volzotan/MirrorForge/simulation/data/mirror.stl

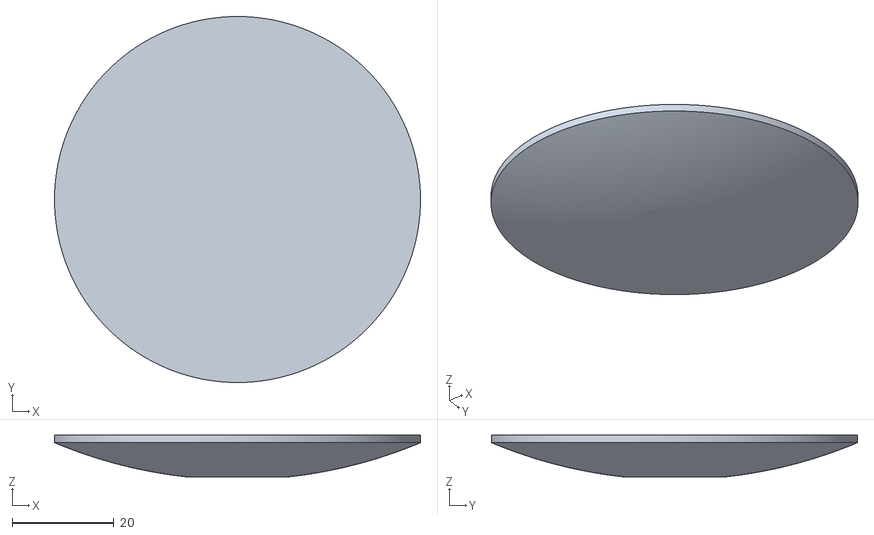
[picture p4: CAD file, 2021-10-08]
simulation/data/mirror.stl
72.0 x 72.0 x 8.23
