volzotan/MirrorForge/simulation/data/CameraWedgeTangible_Head.stl

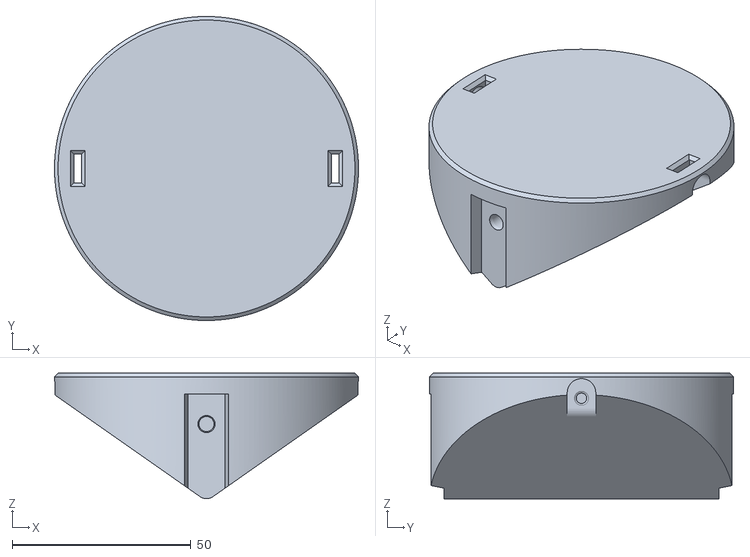
[picture p6: CAD file, 2021-10-08]
simulation/data/CameraWedgeTangible_Head.stl
85.0 x 85.0 x 35.1
