volzotan/MirrorForge/simulation/data/Halopro_base1.stl

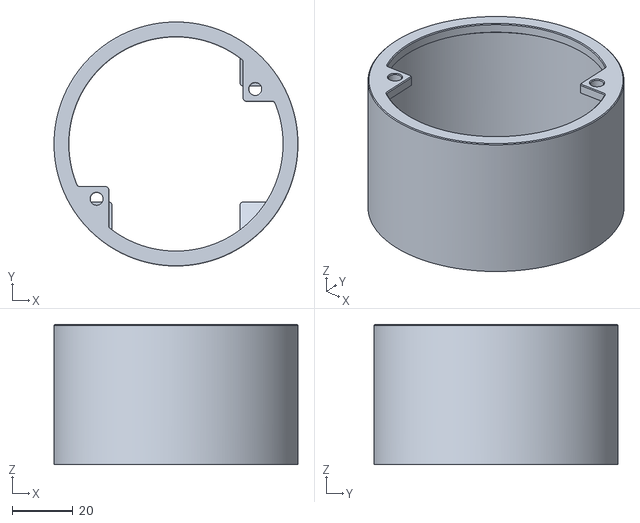
[picture p7: CAD file, 2021-10-08]
simulation/data/Halopro_base1.stl
80.0 x 80.0 x 46.0
