volzotan/MirrorForge/simulation/data/CameraWedgeTangible_Base.stl

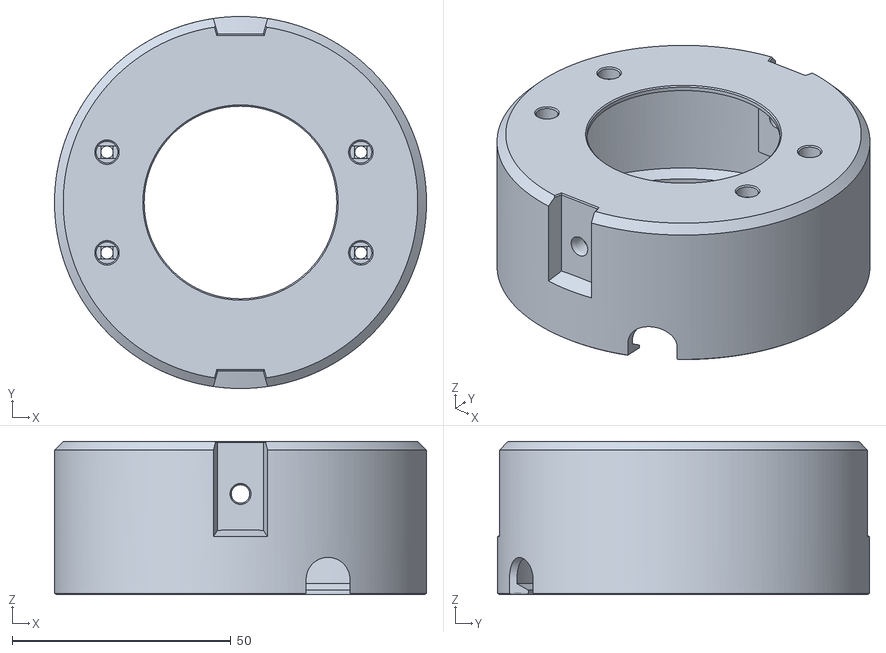
[picture p8: CAD file, 2021-10-08]
simulation/data/CameraWedgeTangible_Base.stl
85.0 x 85.0 x 35.0
