volzotan/MirrorForge/simulation/data/Halopro_base2.stl

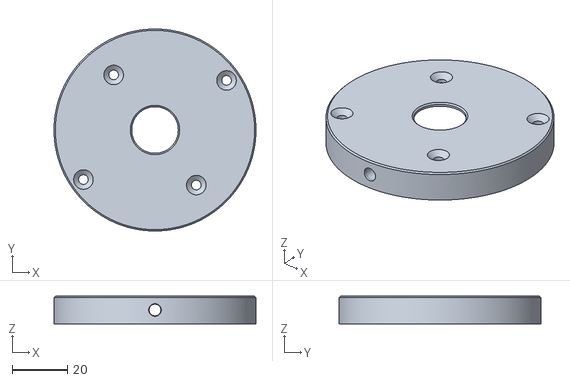
[picture p9: CAD file, 2021-10-08]
simulation/data/Halopro_base2.stl
73.4 x 73.4 x 10.0
