volzotan/MirrorForge/simulation/data/CameraWedgeTangible_Strut.stl

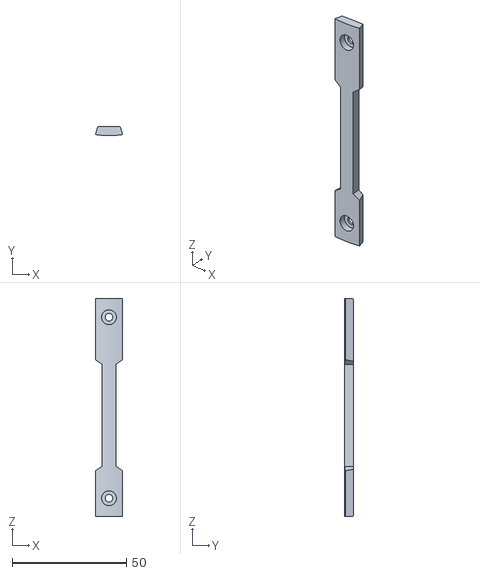
[picture p10: CAD file, 2021-10-08]
simulation/data/CameraWedgeTangible_Strut.stl
11.9 x 4.00 x 95.5
