volzotan/MirrorForge/simulation/data/Body2.stl

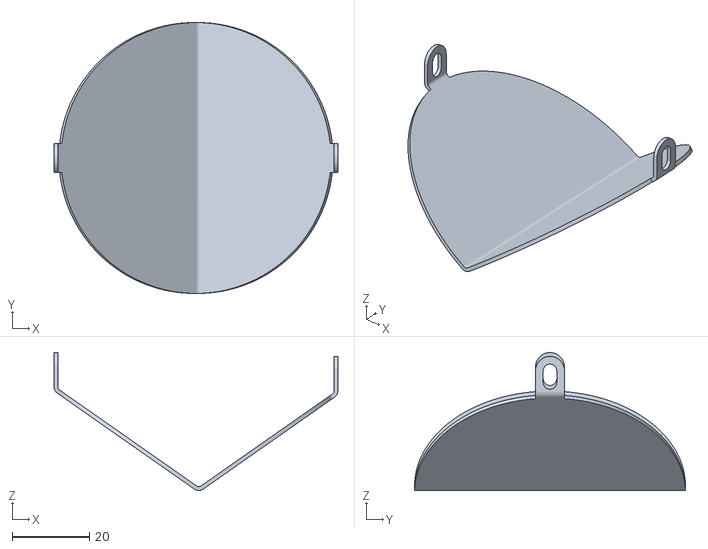
[picture p11: CAD file, 2021-10-08]
simulation/data/Body2.stl
73.4 x 70.0 x 35.7
