volzotan/MirrorForge/(list of files, cad)

Other CAD files:
models/CameraWedgeTangible.f3d
models/halopro.f3z
simulation/output.blend
