volzotan/MirrorForge/evaluation/align_acrylic.jpg

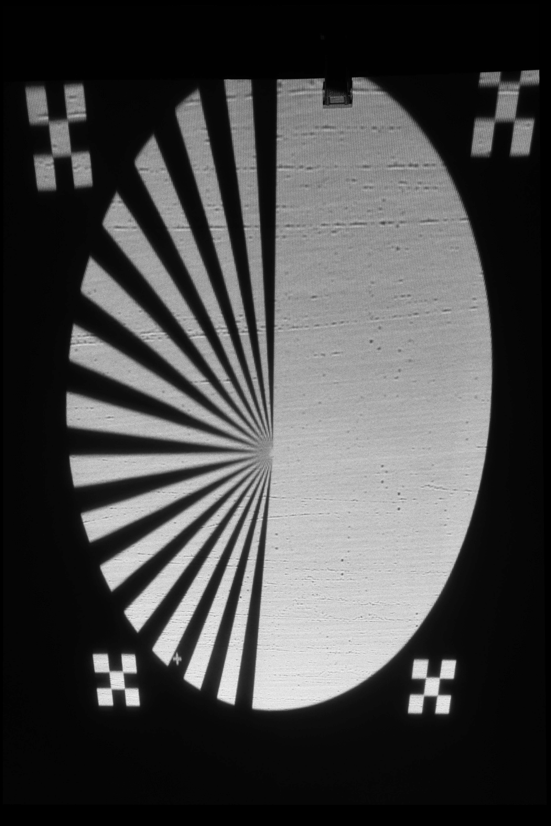
evaluation/align_acrylic.jpg
