volzotan/MirrorForge/evaluation/align_foil.jpg

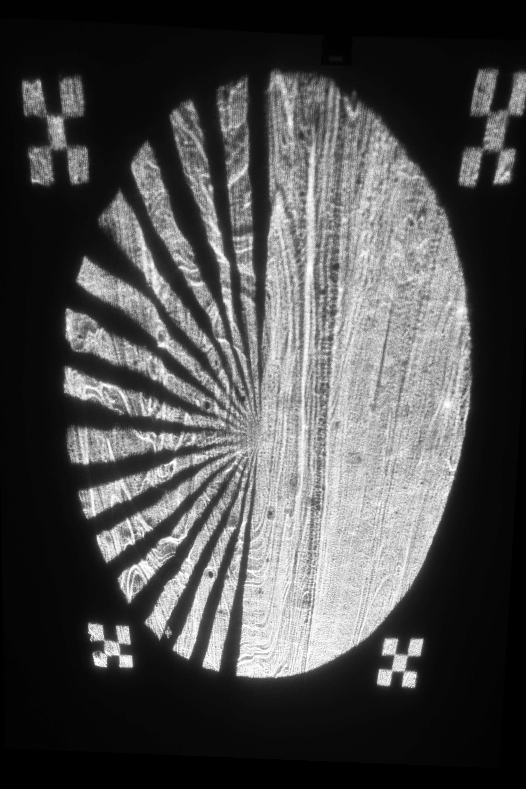
evaluation/align_foil.jpg
