volzotan/MirrorForge/evaluation/align_petg.jpg

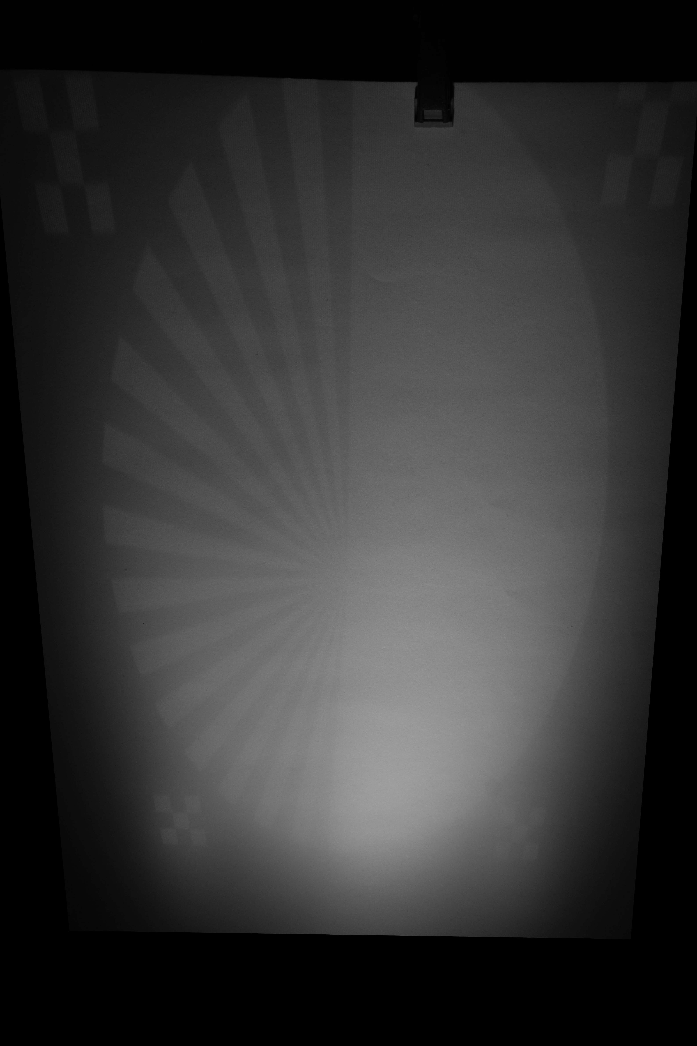
evaluation/align_petg.jpg
