volzotan/MirrorForge/evaluation/align_ps.jpg

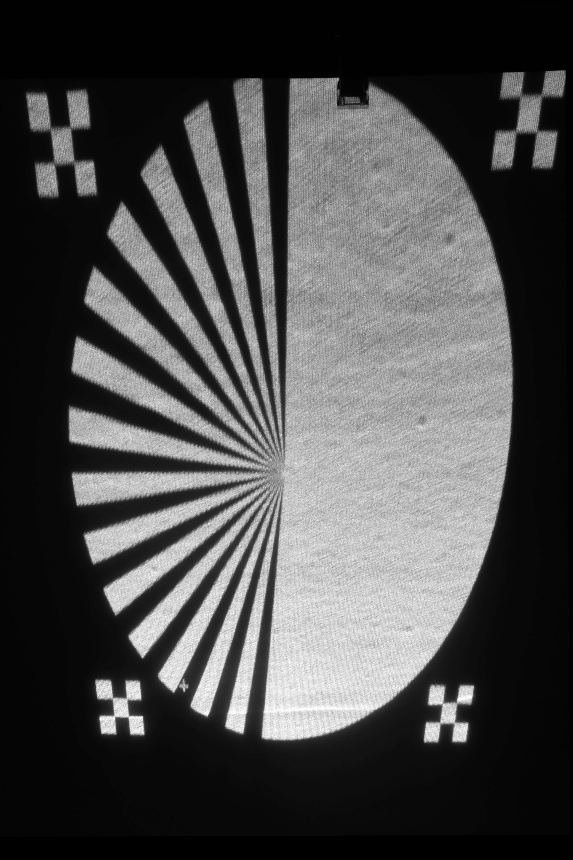
evaluation/align_ps.jpg
