volzotan/MirrorForge/evaluation/diff_acrylic.jpg

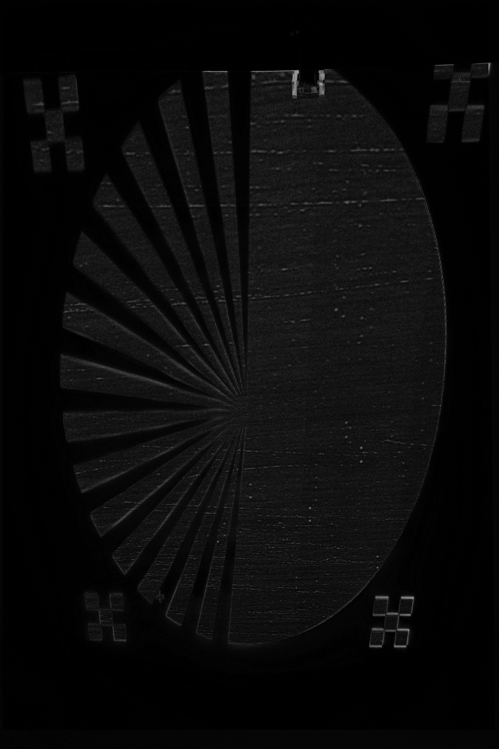
evaluation/diff_acrylic.jpg
