volzotan/MirrorForge/evaluation/diff_foil.jpg

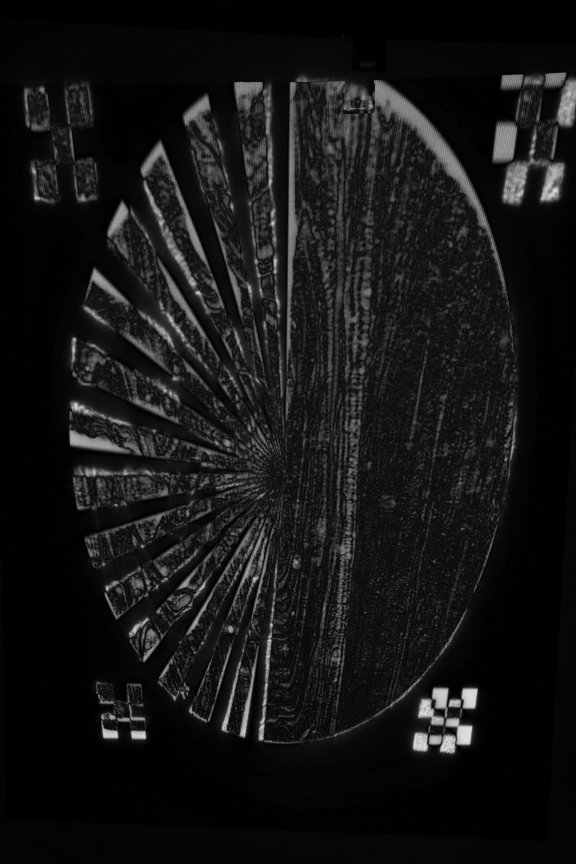
evaluation/diff_foil.jpg
