volzotan/MirrorForge/evaluation/diff_petg.jpg

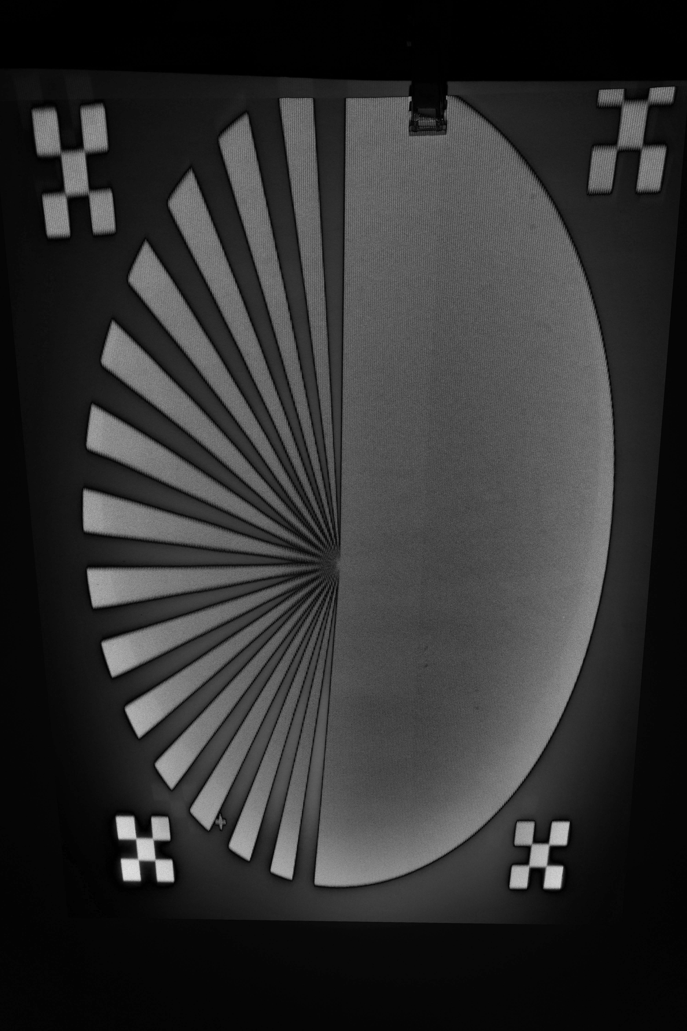
evaluation/diff_petg.jpg
