volzotan/MirrorForge/evaluation/diff_ps.jpg

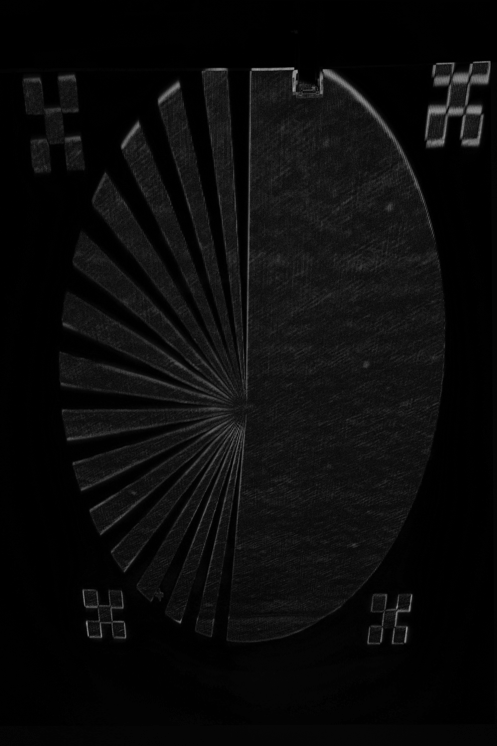
evaluation/diff_ps.jpg
