volzotan/MirrorForge/evaluation/images/acrylic.jpg

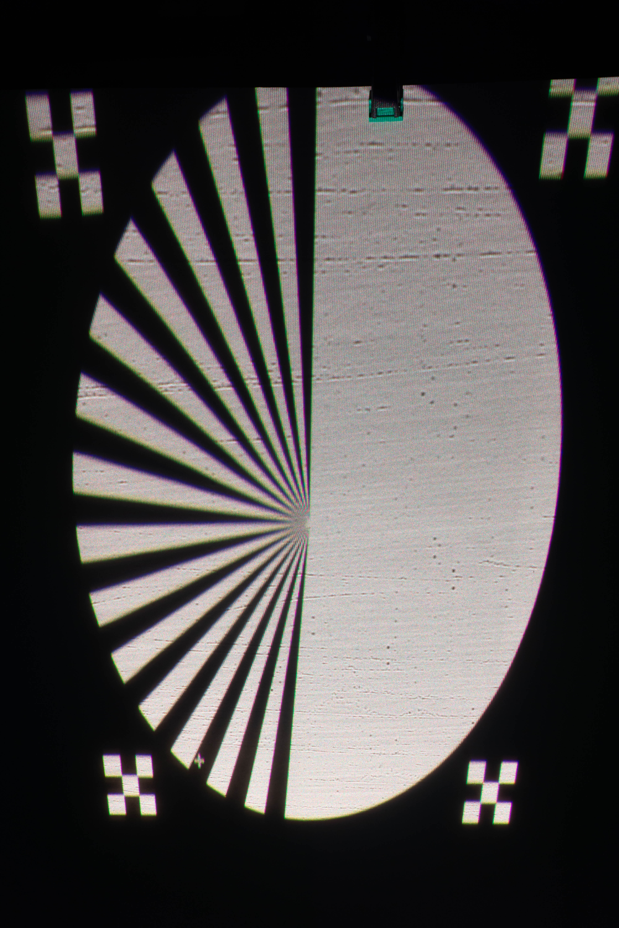
evaluation/images/acrylic.jpg
