volzotan/MirrorForge/evaluation/images/foil.jpg

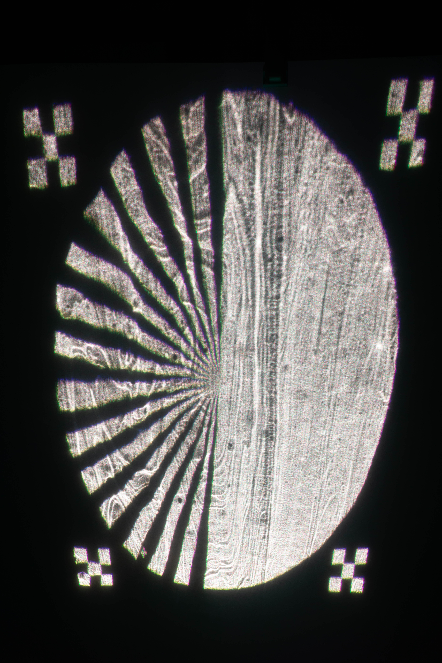
evaluation/images/foil.jpg
