volzotan/MirrorForge/evaluation/images/ps.jpg

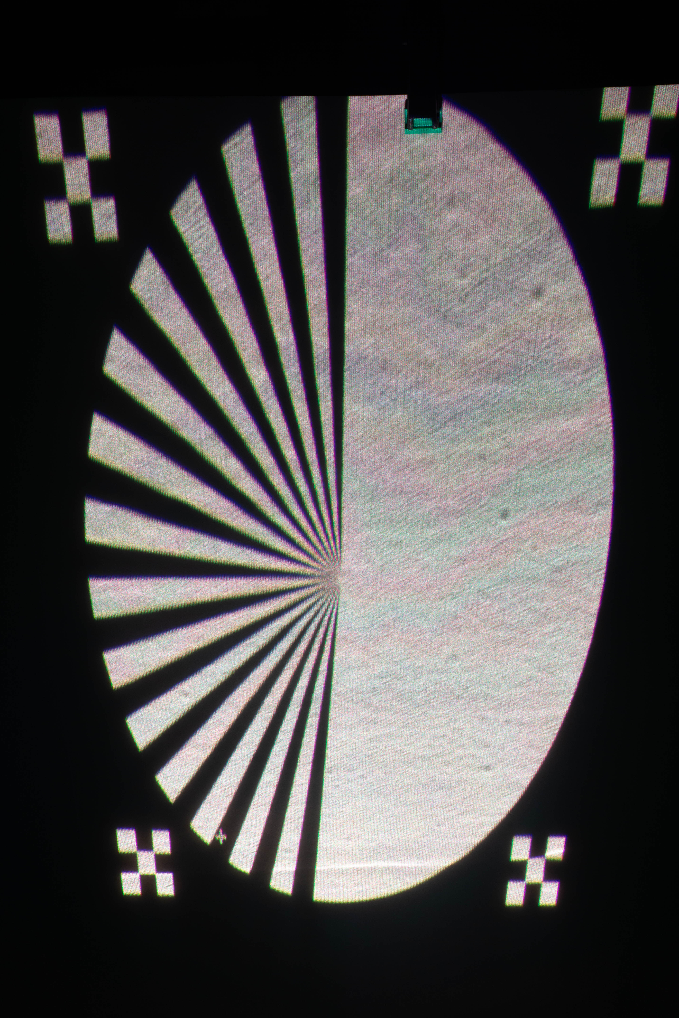
evaluation/images/ps.jpg
