volzotan/MirrorForge/simulation/data/testpattern.png

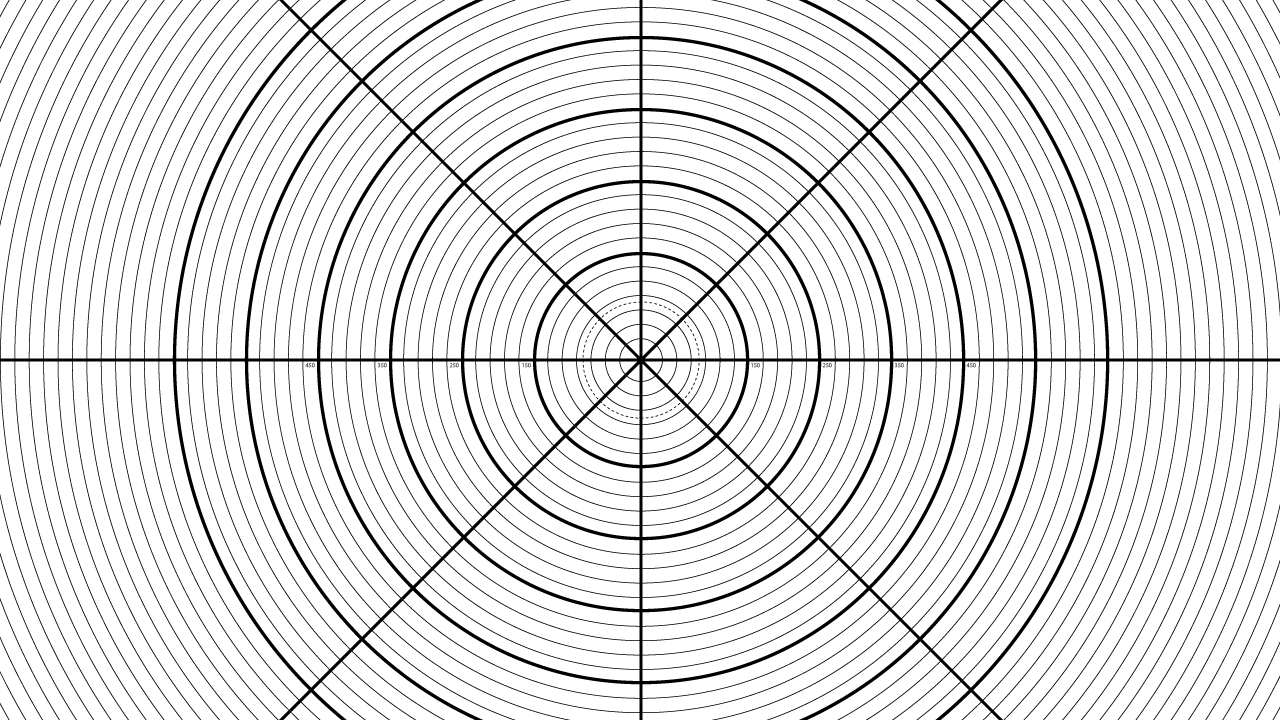
simulation/data/testpattern.png
